zacrogers/blue_usb_midi/3d Models/Enclosure.PNG

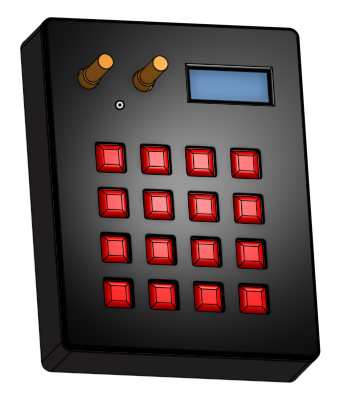
3d Models/Enclosure.PNG
