zacrogers/blue_usb_midi/README.md

# STM32 Blue Pill USB Midi Controller

USB class compliant midi implementation with stm32 blue pill

Grid keypad midi controller. 
8 step sequencer.
LCD display menu for setting parameters.
