zacrogers/blue_usb_midi/documents/menu.md

# Menu 
## Main Modes
Modes are currently selected between by using a toggle switch

Possible future feature is to add display screen for each mode, which is toggled on / off with encoder button long press
* Keypad mode will show last note pressed, current octave, and velocity

		Keypad mode main screen
		|----------------|
		|Note:A#  Vel:127|
		|Oct:10          |
		|----------------|
* Sequencer mode will show last note, bpm, play state, and step index

		Sequencer mode main screen
		|----------------|
		|BPM:150  PLAY   |
		|Note:G#  Step:4 |
		|----------------|

### Keypad
* Change base octave of keyboard
	*  10 octave range
* Change default velocity
	* Values between 0 and 127

			Keypad options menu screen
			|----------------|
			|Keypad          |
			|>Octave   10    |
			|>Velocity 100   |
			|>Back           |
			|----------------|

### Sequencer
* Set tempo
	* Valid between 50 and 200 BPM
* Set note length
	* Set length as percentage of quarter note tempo
* Set step note 
	*  Valid notes between 0 and 127
* Start / stop sequencer playback
	* Will be done with short press of encoder button when on the sequencer mode main screen

			Sequencer options menu screen
			|----------------|
			|Sequencer       |
			|>Tempo  150     |
			|>Length 180     |
			|>Set Step Note  |
			|>Back           |
			|----------------|

			Sequencer note selection menu screen
			|----------------|
			|Set Step Note   |
			|>1  100         |
			|>2  100         |
			|>3  100         |
			|>4  100         |
			|>5  100         |
			|>6  100         |
			|>7  100         |
			|>8  100         |
			|>Back           |
			|----------------|
