zacrogers/blue_usb_midi/3d Models/Main body.stl

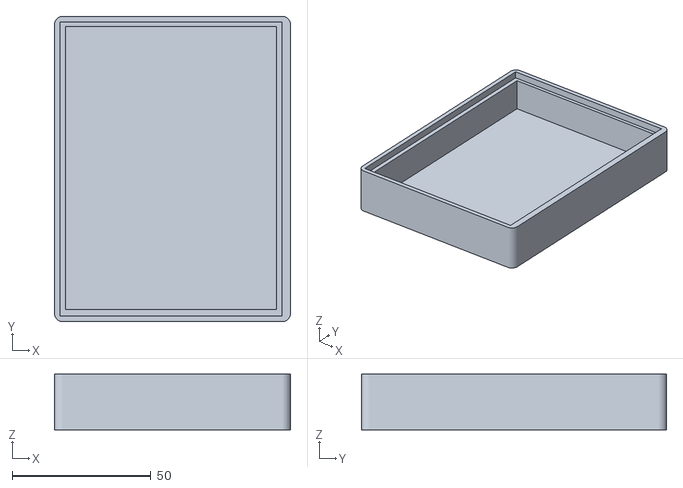
[picture p2: CAD file, 2020-11-14]
3d Models/Main body.stl
85.0 x 110.0 x 20.0
