zacrogers/blue_usb_midi/3d Models/Buttons.stl

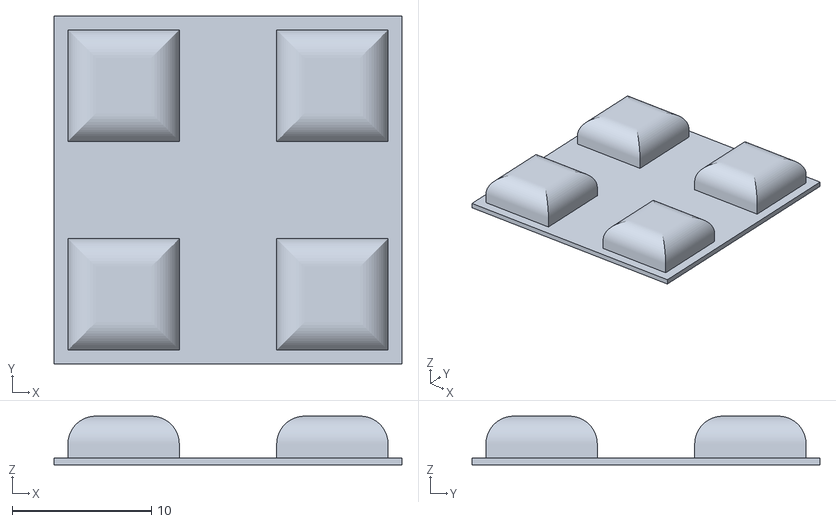
[picture p3: CAD file, 2020-11-14]
3d Models/Buttons.stl
25.0 x 25.0 x 3.50
