zacrogers/blue_usb_midi/3d Models/Faceplate.stl

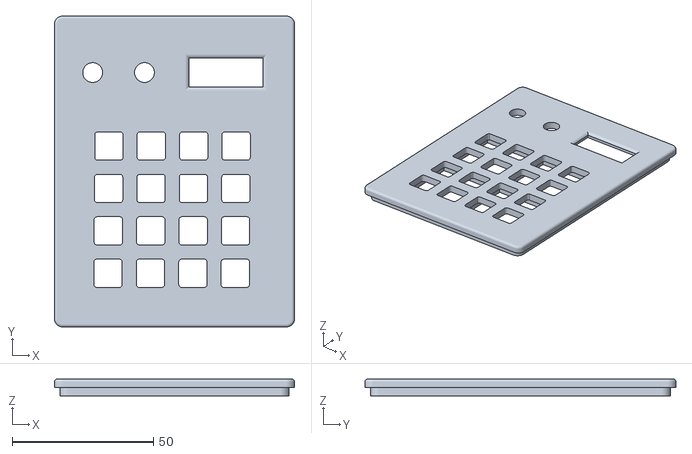
[picture p4: CAD file, 2020-11-14]
3d Models/Faceplate.stl
85.0 x 110.0 x 6.00
