zacrogers/blue_usb_midi/3d Models/Oled.stl

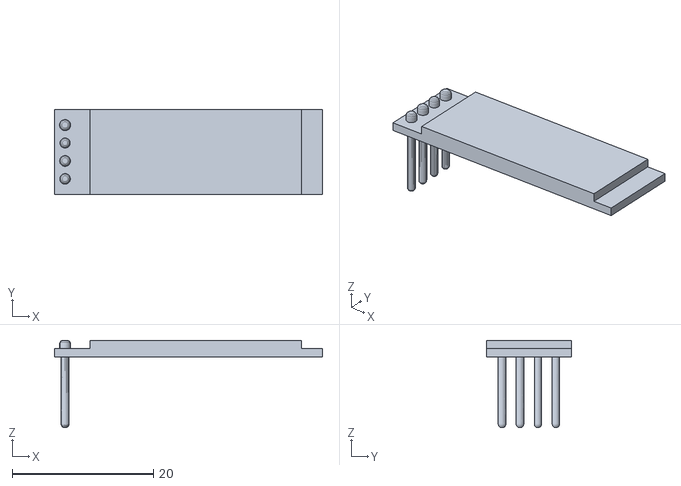
[picture p5: CAD file, 2020-11-14]
3d Models/Oled.stl
38.0 x 12.0 x 12.4
