zacrogers/blue_usb_midi/3d Models/Encoder.stl

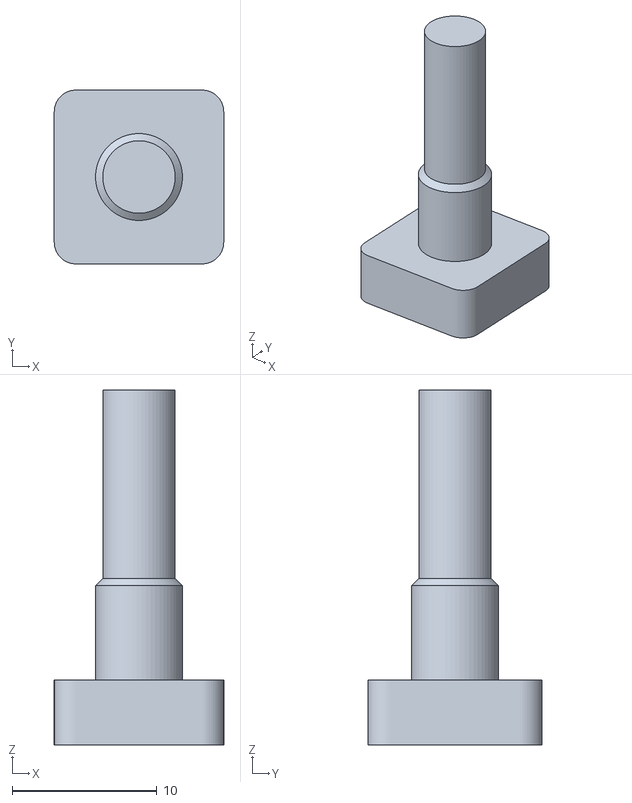
[picture p6: CAD file, 2020-11-14]
3d Models/Encoder.stl
11.7 x 12.0 x 24.5
