zacrogers/blue_usb_midi/(threads)

Thread 3 (2020-11-01):

Setup sequencer timing

zacrogers, 2020-11-01:
Replace the blocking delay based sequencer with a timer based interrupt

zacrogers, 2020-11-04:
Timer is setup and updates the oled display. Still needs to send midi messages.

Closed 2020-11-04.

Thread 7 (2020-11-02):

Fix shift register led mapping

zacrogers, 2020-11-02:
Set the mapping of the encoder values to the shift register led output

Closed 2020-11-03.

Thread 12 (2020-11-04):

Fix sequencer timer not stopping

zacrogers, 2020-11-04:

Closed 2020-11-04.

Thread 15 (2020-11-05):

Fix sequencer timing issues

zacrogers, 2020-11-05:
The sequencer needs to have consistent timing between steps. It currently has slightly different timing, how the interrupt is handled may have to be looked at.

zacrogers, 2020-11-13:
Somehow removing the menu and using 2 encoders solved the problem

Closed 2020-11-13.

Thread 19 (2020-11-11):

Model rocker switch

zacrogers, 2020-11-11:

zacrogers, 2020-11-12:
Changed design to use encoder button for mode changes so no longer necessary

Closed 2020-11-12.

Thread 21 (2020-11-12):

Fix encoder values overshooting

zacrogers, 2020-11-12:

Closed 2020-12-03.

Thread 22 (2020-11-13):

Fix oled inset width

zacrogers, 2020-11-13:
The inset on the back of the faceplate isn't wide enough to accommodate the ribbon cable

Closed 2020-11-13.

Thread 29 (2020-12-09):

Fix sequencer step note changing

zacrogers, 2020-12-09:
When changing sequencer step manually the value sticks to the last changed value, rather than then previous value of the current step.

Closed 2020-12-09.
