zacrogers/blue_usb_midi/Electronics/MidiControllerV1/MidiControllerV1.kicad_pcb

## KiCad design Electronics/MidiControllerV1/MidiControllerV1.kicad_pcb (2021-04-01, an earlier design)

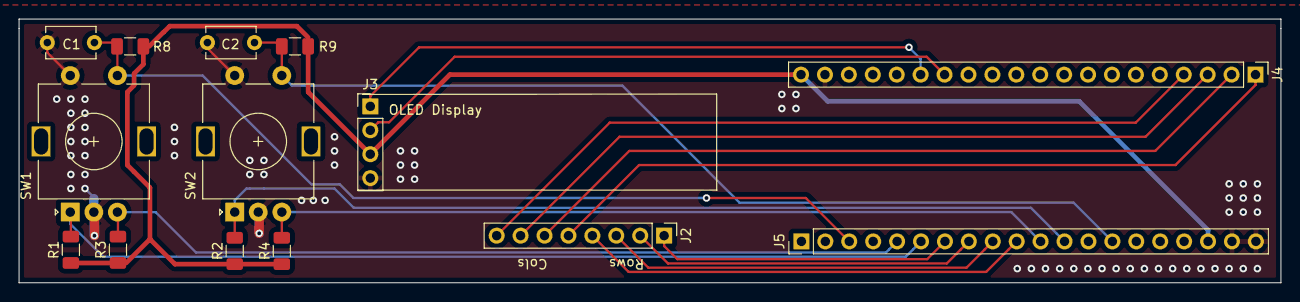
[picture p7: board MidiControllerV1.kicad_pcb from above]

Board: 2 copper layers, 134.0 x 28.0 mm, 14 parts (0 on the bottom side), 18 nets.

Parts:
C1, C2: C; C_Disc_D5.1mm_W3.2mm_P5.00mm
J2: KeypadConnector; PinHeader_1x08_P2.54mm_Vertical
J3: OledConnector; PinHeader_1x04_P2.54mm_Vertical
J4: BluePillHeaderA; PinHeader_1x20_P2.54mm_Vertical
J5: BluepillHeaderB; PinHeader_1x20_P2.54mm_Vertical
R1, R2, R3, R4, R8, R9: R; R_1206_3216Metric
SW1, SW2: Rotary_Encoder_Switch; RotaryEncoder_Alps_EC11E-Switch_Vertical_H20mm

Connections:
+3V3: J3.3, J4.20, J5.18, R1.1, R2.1, R3.1, R4.1, R8.1, R9.1
ENC1A: J5.6, R1.2, SW1.A
ENC1B: J5.5, R3.2, SW1.B
ENC1_SW: C1.1, J5.3, R8.2, SW1.S1
ENC2A: J5.12, R2.2, SW2.A
ENC2B: J5.11, R4.2, SW2.B
ENC2_SW: C2.1, J5.14, R9.2, SW2.S1
GND: C1.2, C2.2, J3.4, J4.19, J5.19, J5.20, SW1.C, SW1.S2, SW2.C, SW2.S2
KP_C1: J2.5, J4.1
KP_C2: J2.6, J4.2
KP_C3: J2.7, J4.3
KP_C4: J2.8, J4.4
KP_R1: J2.1, J5.7
KP_R2: J2.2, J5.8
KP_R3: J2.3, J5.9
KP_R4: J2.4, J5.10
LCD_SCL: J3.2, J4.14
LCD_SDA: J3.1, J4.15
