zacrogers/blue_usb_midi/Electronics/MidiControllerV2/MidiControllerV2.kicad_pcb

## KiCad design Electronics/MidiControllerV2/MidiControllerV2.kicad_pcb (2021-04-01, an earlier design)

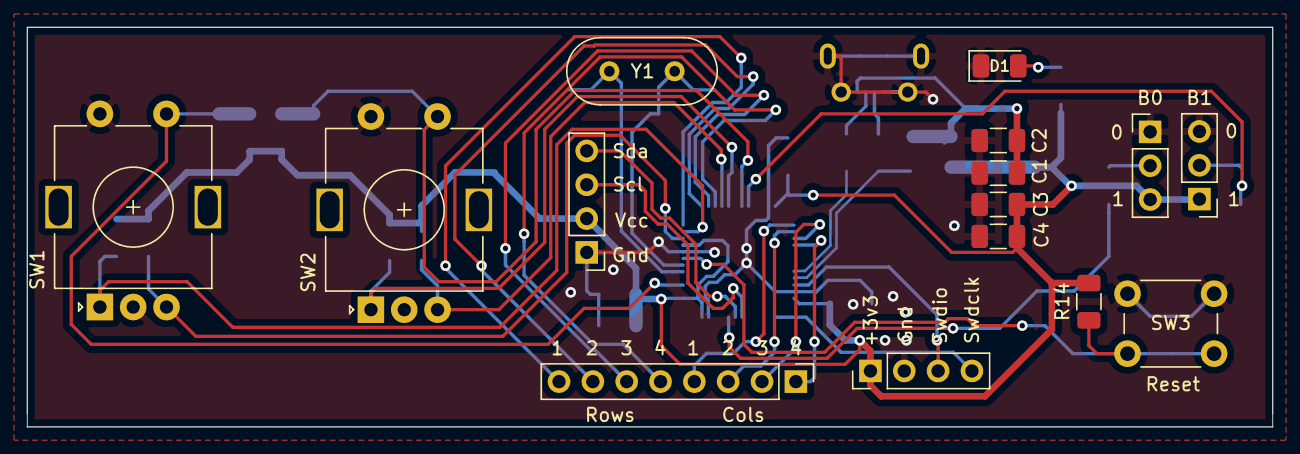
[picture p8: board MidiControllerV2.kicad_pcb from above]

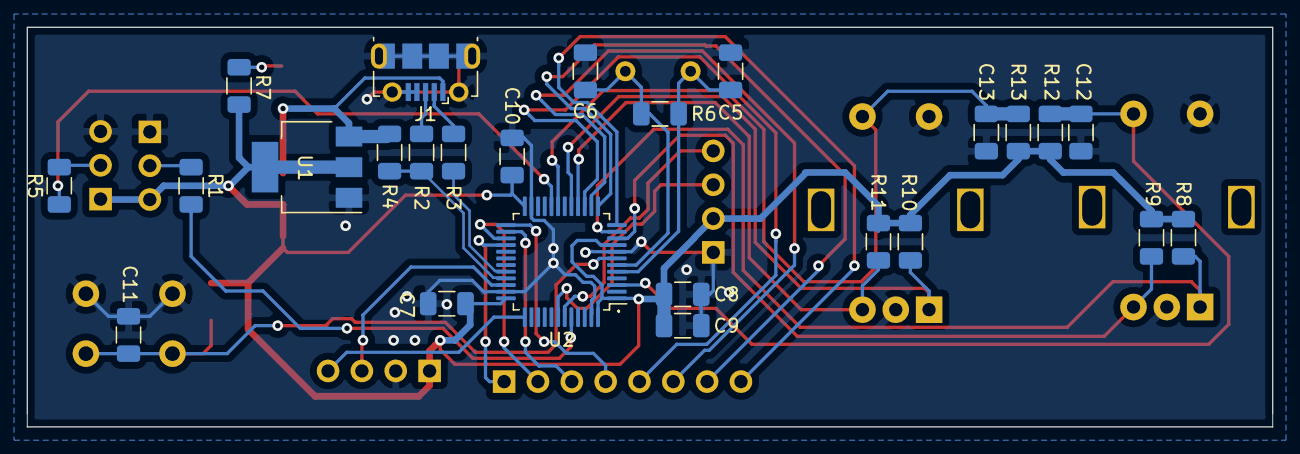
[picture p9: board MidiControllerV2.kicad_pcb from below]

Board: 2 copper layers, 93.5 x 30.0 mm, 40 parts (25 on the bottom side), 33 nets.

Parts:
C1, C2, C3, C4, C5, C6, C7, C8, C9, C10, C11, C12, C13: C; C_1206_3216Metric
D1: LED; LED_1206_3216Metric
J1: USB_B_Micro; USB_Micro-B_Molex-105017-0001
J2: BOOT0_H; PinHeader_1x03_P2.54mm_Vertical
J3: BOOT1_H; PinHeader_1x03_P2.54mm_Vertical
J4, J6: Conn_01x04_Male; PinHeader_1x04_P2.54mm_Vertical
J5: Conn_01x08_Male; PinHeader_1x08_P2.54mm_Vertical
R1, R2, R3, R4, R5, R7, R8, R9, R10, R11, R12, R13, R14: R; R_1206_3216Metric
R6: R; C_1206_3216Metric
SW1, SW2: Encoder; RotaryEncoder_Alps_EC11E-Switch_Vertical_H20mm
SW3: SW_DPST; SW_PUSH_6mm
U1: AMS1117-3.3; SOT-223-3_TabPin2
U2: STM32F100C8Tx; LQFP-48_7x7mm_P0.5mm
Y1: Crystal; Crystal_HC18-U_Vertical

Connections:
+3V3: C3.1, C4.1, C7.1, C8.1, C9.1, C10.1, J2.3, J3.1, J4.1, J6.2, R7.1, R8.2, R9.2, R10.2, R11.2, R12.2, R13.2, R14.1, U1.2, U2.1, U2.9, U2.24, U2.36, U2.48
+5V: C1.1, C2.1, J1.1, R4.1, U1.3
BOOT0: R1.2, U2.44
BOOT1: R5.1, U2.20
ENC1A: R8.1, SW1.A, U2.11
ENC1B: R9.1, SW1.B, U2.10
ENC1_SW: C12.1, R12.1, SW1.S1, U2.3
ENC2A: R10.1, SW2.A, U2.17
ENC2B: R11.1, SW2.B, U2.16
ENC2_SW: C13.1, R13.1, SW2.S1, U2.19
GND: C1.2, C2.2, C3.2, C4.2, C5.2, C6.2, C7.2, C8.2, C9.2, C10.2, C11.2, C12.2, C13.2, D1.1, J1.4, J1.5, J1.6, J2.1, J3.3, J4.2, J6.1, SW1.C, SW1.S2, SW2.C, SW2.S2, SW3.1, U1.1, U2.8, U2.23, U2.35, U2.47
KP_C1: J5.4, U2.25
KP_C2: J5.3, U2.26
KP_C3: J5.2, U2.27
KP_C4: J5.1, U2.28
KP_R1: J5.8, U2.12
KP_R2: J5.7, U2.13
KP_R3: J5.6, U2.14
KP_R4: J5.5, U2.15
unnamed: D1.2, R7.2
unnamed: J1.2, R3.2
unnamed: J1.3, R2.2
unnamed: J2.2, R1.1
unnamed: J3.2, R5.2
OLED_SCL: J6.3, U2.42
OLED_SDA: J6.4, U2.43
OSCIN: C5.1, R6.2, U2.5, Y1.1
OSCOUT: C6.1, R6.1, U2.6, Y1.2
RESET: C11.1, R14.2, SW3.2, U2.7
SWDCLK: J4.4, U2.37
SWDIO: J4.3, U2.34
USBD+: R2.1, R4.2, U2.33
USBD-: R3.1, U2.32
