zacrogers/blue_usb_midi/Core/Inc/main.h

#define OB_LED_PORT      GPIOC
#define OB_LED_PIN       GPIO_PIN_13
#define ENC_BTN_PORT     GPIOC
#define ENC_BTN_PIN      GPIO_PIN_14
#define ENC2_BTN_PORT    GPIOB
#define ENC2_BTN_PIN     GPIO_PIN_1
#define MAX_MIDI_OCTAVES 10
#define MAX_MIDI_NOTE    127
#define MAX_VELOCITY     127
#define MAX_NOTE_LEN     10
#define MIN_NOTE_LEN     1
#define NUM_SEMITONES    12
#define NUM_BUTTONS      16
#define MIN_BPM          50
#define MAX_BPM          200
#define OLED_ROW_1       0
#define OLED_ROW_2       20
#define OLED_ROW_3       40
#define SEQ_FR_TOP       44
#define N_SEQ_STEPS      8
