zacrogers/blue_usb_midi/Core/Inc/i2c-lcd.h

#include "stm32f1xx_hal.h"
/*
 * Library for hitachi lcd display with i2c backpack
 *
 */
#ifndef I2C_LCD_H
#define I2C_LCD_H

#define LCD_CLEAR              0x01
#define LCD_HOME               0x02
#define LCD_CURSOR_DECR        0x10
#define LCD_CURSOR_INCR        0x14

#define LCD_SHIFT_DISP_R       0x05
#define LCD_SHIFT_DISP_L       0x07

#define LCD_DISP_OFF_CUR_OFF   0x08
#define LCD_DISP_OFF_CUR_ON    0x0A
#define LCD_DISP_ON_CUR_OFF    0x0C
#define LCD_CUR_BLINK_OFF      0x0E
#define LCD_CUR_BLINK_ON       0x0F

#define LCD_CUR_HOME_1         0x80
#define LCD_CUR_HOME_2         0xC0

#define LCD_MODE_4BIT          0x28


typedef struct
{
	I2C_HandleTypeDef *i2c_bus;
	uint8_t            address; //bit shift address by 1
	uint8_t            lines;
	uint8_t            columns;
	uint8_t            mode;
}I2C_LCD;


void LCD_Init                (I2C_LCD *lcd);                   // initialize lcd

void LCD_SendCmd             (I2C_LCD *lcd, char cmd);      // send command to the lcd

void LCD_SendData            (I2C_LCD *lcd, char data);    // send data to the lcd

void LCD_SendString          (I2C_LCD *lcd, char *str);  // send string to the lcd

void LCD_Clear               (I2C_LCD *lcd);

void LCD_EnableCursorBlink   (I2C_LCD *lcd);

void LCD_DisableCursorBlink  (I2C_LCD *lcd);

void LCD_EnableCursor        (I2C_LCD *lcd);

void LCD_DisableCursor       (I2C_LCD *lcd);

void LCD_SetCursor           (I2C_LCD *lcd, uint8_t line, uint8_t col);


#endif /* I2C_LCD_H */
