zacrogers/blue_usb_midi/(commit log)

2020-10-28 On branch master Initial commit
    [blue_usb_midi Debug.cfg]
2020-10-29 Added rotary encoder
2020-10-30 Added isr for button
2020-11-01 #2 Placed basic components
    Copied components from generic schematic of blue pill and added other parts
    [MidiControllerV1.kicad_pcb, MidiControllerV1.sch]
2020-11-02 #2 Schematic wired up
    [MidiControllerV1.sch]
2020-11-02 Fixed screen switching
2020-11-04 #3 Sequencer timer setup
2020-11-04 #11 Fixed sequencer timer blocking encoder
    [main.c, main.h]
2020-11-11 Added second encoder functions
2020-11-12 #20 Changed sequencer timer to TIM4
2020-11-12 Added 3d models
    [Buttons.stl, Encoder.stl, Faceplate.stl, Oled.stl]
2020-11-13 Updated enclosure faceplate & main body
    [Faceplate.stl, Main body.stl]
2020-11-13 #20 Second encoder added
2020-11-13 Setup sequencer encoder mapping
2020-11-13 Updated schematic
    Schematic updated to use blue pill board plugged into headers
    [MidiControllerV1.sch]
2020-11-14 Components placed on pcb
    [MidiControllerV1.sch]
2020-11-14 #25 Sequencer note selection kind of working
    [MidiControllerV1.sch]
2020-11-16 #24 Laid out pcb
    [MidiControllerV1.kicad_pcb]
2020-11-18 Finished PCB layout
    [MidiControllerV1.kicad_pcb]
2020-11-19 Generated gerber files
    [MidiControllerV1-B_Cu.gbr, MidiControllerV1-B_Mask.gbr, MidiControllerV1-B_SilkS.gbr, MidiControllerV1-Edge_Cuts.gbr, MidiControllerV1-F_Cu.gbr, MidiControllerV1-F_Mask.gbr, MidiControllerV1-F_SilkS.gbr, MidiControllerV1.drl]
2020-11-28 #25 Fixed encoder and button mapping
    [main.c]
2020-11-30 #21 Fixed oncoder overshooting max value
    [main.c, main.h]
2020-12-03 #27 #21 Fixed value sticking and overshooting
    [main.c]
2020-12-04 Refactored encoder handling
2020-12-09 #29 Fixed sequencer value sticking
    [main.c]
2020-12-11 Added circuit breakout schematic
    [Keypad.sch, MidiControllerV2.kicad_pcb, MidiControllerV2.sch, SSD1306Oled.sch]
2021-01-08 #32 Laid out rev1 schematic
    [MidiControllerV2.sch, SSD1306Oled.sch]
2021-01-11 #32 Pcb v2 components placed
    [Keypad.sch, MidiControllerV2.sch]
2021-01-11 #32 Pcb v2 power traces laid
2021-01-25 #32 Pcb layout revised
    [MidiControllerV2.kicad_pcb]
2021-04-01 #32 Updated pcb v1
    [Keypad.sch, MidiControllerV1.kicad_pcb, MidiControllerV1.sch, MidiControllerV2.kicad_pcb, MidiControllerV2.sch, SSD1306Oled.sch]
